Filikapec/deltaf/README.md

# DELTAF
Source code for project DELTA F

Glavni program se nalazi u dokumentu "app finalno.py"

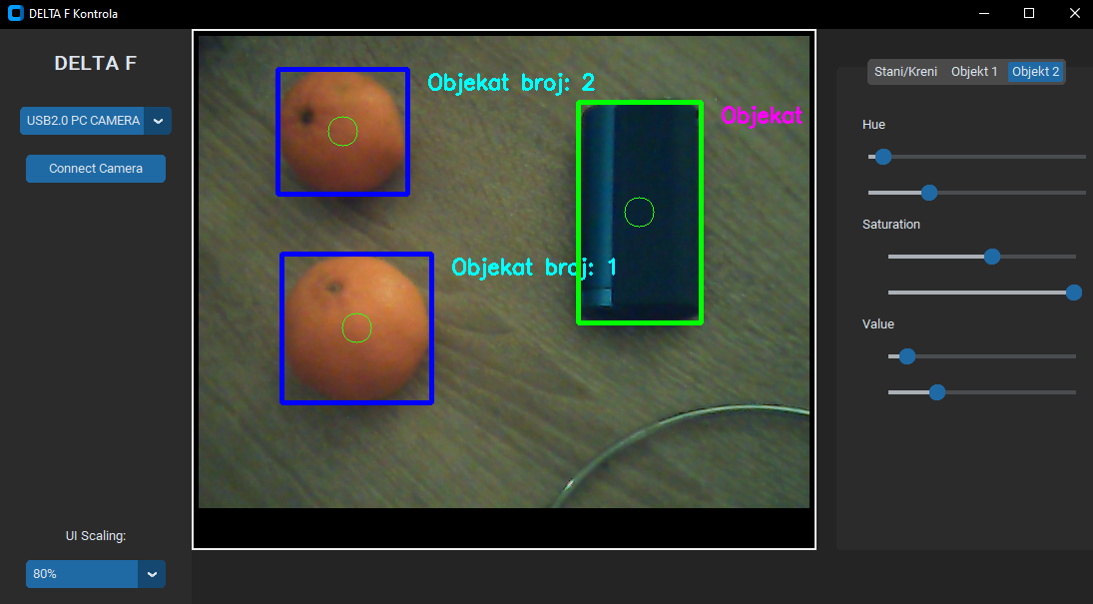
[picture p1: slika_programa_17122022_0218.PNG]


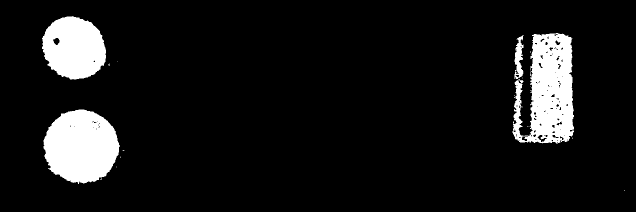
[picture p2: slika_programa_17122022_0218_2.PNG]


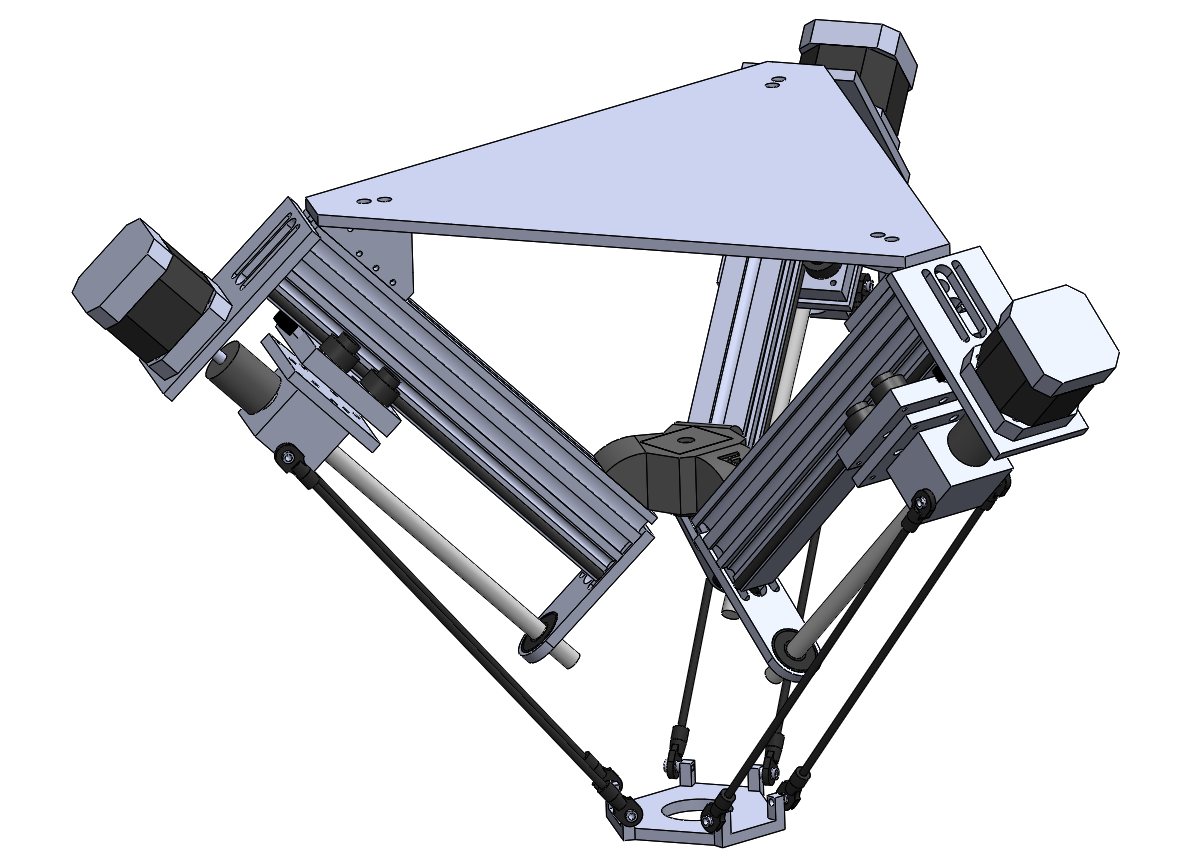
[picture p3: cela delta.PNG]
