Filikapec/deltaf/CELA DELTA.STEP

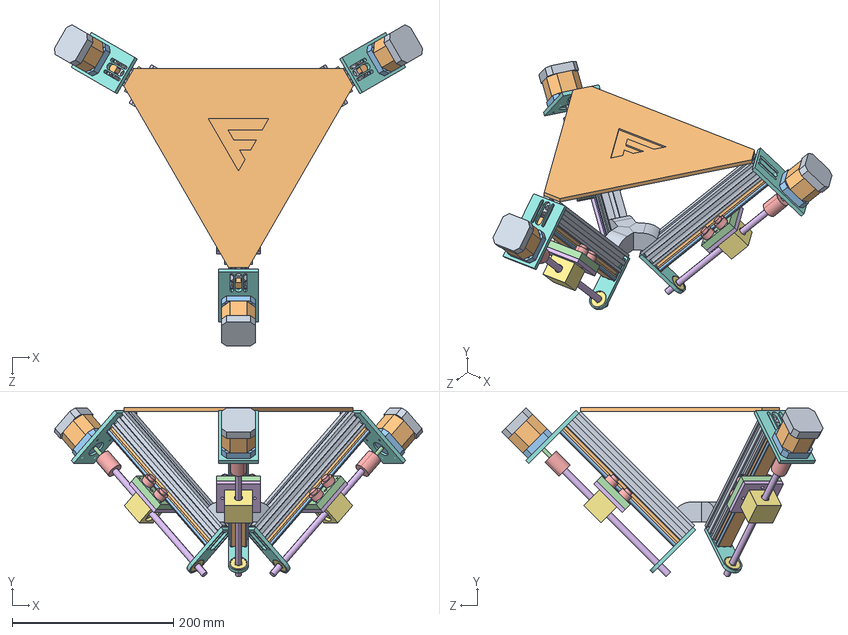
[picture p16: CAD file, 2023-03-24]
CELA DELTA.STEP
456.6 x 210.1 x 398.6 mm
Profil 25x25 x 3
sina x 3
sinavaljak x 6
klizacposini x 3
lagernakolicima x 12
klizacspojsakucistem x 3
kucistematica x 3
nosac motora x 3
stepperdonjideo x 3
steppersrednjideo x 3
steppergornjideo x 3
osovinasteppera x 3
spojnicamotorvreteno x 3
navojnovretenojednostavno x 3
lezaj neki x 3
nosac sa lezajem manji x 3
donja spojnica profila
Baza trouglasta sa logoom
