Filikapec/deltaf/app finalno.py

import tkinter as tk # pip install tk
import customtkinter # pip install customtkinter
import PIL.Image, PIL.ImageTk # pip install pillow
import cv2 # pip install opencv-python
from pygrabber.dshow_graph import FilterGraph # pip install pygrabber
import numpy as np
import sastavljanjeslika as slike
import klasapozicije as klasa
import serial
import time

customtkinter.set_appearance_mode("dark")  # Modes: "System" (standard), "Dark", "Light"
customtkinter.set_default_color_theme("blue")  # Themes: "blue" (standard), "green", "dark-blue"

pozicije = []
#brojobjekata = 0

#======================= SERIJSKA ============================
delta = serial.Serial(port='COM7', baudrate=9600, timeout=.1)
time.sleep(0.1)


class App(customtkinter.CTk):
    def __init__(self):
        super().__init__()

        # configure window
        self.title("DELTA F Kontrola")
        self.geometry("1100x580")

        # configure grid layout (4x4)
        self.grid_columnconfigure(1, weight=1)
        self.grid_columnconfigure((2, 3), weight=0)
        self.grid_rowconfigure((0, 1, 2), weight=1)

        # create sidebar frame with widgets
        self.sidebar_frame = customtkinter.CTkFrame(self, width=350, corner_radius=0)
        self.sidebar_frame.grid(row=0, column=0, rowspan=4, sticky="nsew")
        self.sidebar_frame.grid_rowconfigure(4, weight=1)
        self.logo_label = customtkinter.CTkLabel(self.sidebar_frame, text="DELTA F", font=customtkinter.CTkFont(size=20, weight="bold"))
        self.logo_label.grid(row=0, column=0, padx=20, pady=(20, 10))

        #get the available video devices
        self.graph = FilterGraph()
 
        # fill combobox with availible video devices
        self.combobox = customtkinter.CTkOptionMenu(self.sidebar_frame, values=self.graph.get_input_devices())
        self.combobox.grid(row=1, column=0, padx=20, pady=(20, 10))

        # connect button
        self.sidebar_button_1 = customtkinter.CTkButton(self.sidebar_frame, text="Connect Camera", command=self.sidebar_button_event)
        self.sidebar_button_1.grid(row=2, column=0, padx=20, pady=10)

        self.tabview = customtkinter.CTkTabview(self, width=250)
        self.tabview.grid(row=0, column=2, padx=(20, 0), pady=(20, 0), sticky="nsew")
        self.tabview.add("Stani/Kreni")
        self.tabview.add("Objekt 1")
        self.tabview.add("Objekt 2")
        self.tabview.tab("Stani/Kreni").grid_columnconfigure(0, weight=1)  # configure grid of individual tabs
        self.tabview.tab("Objekt 1").grid_columnconfigure(0, weight=1)
        #prvi tab
        self.zapocnibtn = customtkinter.CTkButton(self.tabview.tab("Stani/Kreni"), text="Zapocni", command=self.pozicijeIspis)
        self.zaustavibtn = customtkinter.CTkButton(self.tabview.tab("Stani/Kreni"), text="Zaustavi")
        self.sakrijplatformubtn = customtkinter.CTkButton(self.tabview.tab("Stani/Kreni"), text="Pregledaj", command=self.sakrijplatformu)
        self.zapocnibtn.grid(row=0, column=0, padx=20, pady=(30,10))
        self.zaustavibtn.grid(row=1, column=0, padx=20, pady=10)
        self.sakrijplatformubtn.grid(row=2, column=0, padx=20, pady=10)
        #drugi tab
        self.slider_progressbar_frame = customtkinter.CTkFrame(self.tabview.tab("Objekt 1"), fg_color="transparent")
        self.slider_progressbar_frame.grid(row=1, column=1, columnspan=2, padx=(20, 0), pady=(20, 0), sticky="nsew")
        self.slider_progressbar_frame.grid_columnconfigure(0, weight=1)
        self.slider_progressbar_frame.grid_rowconfigure(4, weight=1)
        #treci tab
        self.slider_progressbar_frame2 = customtkinter.CTkFrame(self.tabview.tab("Objekt 2"), fg_color="transparent")
        self.slider_progressbar_frame2.grid(row=1, column=1, columnspan=2, padx=(20, 0), pady=(20, 0), sticky="nsew")
        self.slider_progressbar_frame2.grid_columnconfigure(0, weight=1)
        self.slider_progressbar_frame2.grid_rowconfigure(4, weight=1)
        #HSV1
        self.labelH1 = customtkinter.CTkLabel(self.slider_progressbar_frame, text="Hue")
        self.labelH1.grid(row=0, column=0, padx=(0,0), pady=(0, 0), sticky="nw")
        self.slider_1 = customtkinter.CTkSlider(self.slider_progressbar_frame, from_=0, to=180, number_of_steps=180)
        self.slider_1.grid(row=1, column=0, padx=(0, 0), pady=(10, 10), sticky="ew")
        self.labelS1 = customtkinter.CTkLabel(self.slider_progressbar_frame, text="Saturation")
        self.labelS1.grid(row=3, column=0, padx=(0,0), pady=(0, 0), sticky="nw")
        self.slider_2 = customtkinter.CTkSlider(self.slider_progressbar_frame, from_=0, to=255, number_of_steps=180)
        self.slider_2.grid(row=4, column=0, padx=(20, 10), pady=(10, 10), sticky="ew")
        self.labelV1 = customtkinter.CTkLabel(self.slider_progressbar_frame, text="Value")
        self.labelV1.grid(row=6, column=0, padx=(0,0), pady=(0, 0), sticky="nw")
        self.slider_3 = customtkinter.CTkSlider(self.slider_progressbar_frame, from_=0, to=255, number_of_steps=180)
        self.slider_3.grid(row=7, column=0, padx=(20, 10), pady=(10, 10), sticky="ew")
        #HSV2
        self.slider_4 = customtkinter.CTkSlider(self.slider_progressbar_frame, from_=0, to=180, number_of_steps=180)
        self.slider_4.grid(row=2, column=0, padx=(0, 0), pady=(10, 10), sticky="ew")
        self.slider_5 = customtkinter.CTkSlider(self.slider_progressbar_frame, from_=0, to=255, number_of_steps=180)
        self.slider_5.grid(row=5, column=0, padx=(20, 10), pady=(10, 10), sticky="ew")
        self.slider_6 = customtkinter.CTkSlider(self.slider_progressbar_frame, from_=0, to=255, number_of_steps=180)
        self.slider_6.grid(row=8, column=0, padx=(20, 10), pady=(10, 10), sticky="ew")
        #HSV3
        self.labelH12 = customtkinter.CTkLabel(self.slider_progressbar_frame2, text="Hue")
        self.labelH12.grid(row=0, column=0, padx=(0,0), pady=(0, 0), sticky="nw")
        self.slider_12 = customtkinter.CTkSlider(self.slider_progressbar_frame2, from_=0, to=180, number_of_steps=180)
        self.slider_12.grid(row=1, column=0, padx=(0, 0), pady=(10, 10), sticky="ew")
        self.labelS12 = customtkinter.CTkLabel(self.slider_progressbar_frame2, text="Saturation")
        self.labelS12.grid(row=3, column=0, padx=(0,0), pady=(0, 0), sticky="nw")
        self.slider_22 = customtkinter.CTkSlider(self.slider_progressbar_frame2, from_=0, to=255, number_of_steps=180)
        self.slider_22.grid(row=4, column=0, padx=(20, 10), pady=(10, 10), sticky="ew")
        self.labelV12 = customtkinter.CTkLabel(self.slider_progressbar_frame2, text="Value")
        self.labelV12.grid(row=6, column=0, padx=(0,0), pady=(0, 0), sticky="nw")
        self.slider_32 = customtkinter.CTkSlider(self.slider_progressbar_frame2, from_=0, to=255, number_of_steps=180)
        self.slider_32.grid(row=7, column=0, padx=(20, 10), pady=(10, 10), sticky="ew")
        #HSV4
        self.slider_42 = customtkinter.CTkSlider(self.slider_progressbar_frame2, from_=0, to=180, number_of_steps=180)
        self.slider_42.grid(row=2, column=0, padx=(0, 0), pady=(10, 10), sticky="ew")
        self.slider_52 = customtkinter.CTkSlider(self.slider_progressbar_frame2, from_=0, to=255, number_of_steps=180)
        self.slider_52.grid(row=5, column=0, padx=(20, 10), pady=(10, 10), sticky="ew")
        self.slider_62 = customtkinter.CTkSlider(self.slider_progressbar_frame2, from_=0, to=255, number_of_steps=180)
        self.slider_62.grid(row=8, column=0, padx=(20, 10), pady=(10, 10), sticky="ew")

        self.scaling_label = customtkinter.CTkLabel(self.sidebar_frame, text="UI Scaling:", anchor="w")
        self.scaling_label.grid(row=7, column=0, padx=20, pady=(10, 0))
        self.scaling_optionemenu = customtkinter.CTkOptionMenu(self.sidebar_frame, values=["80%", "90%", "100%", "110%", "120%"], command=self.change_scaling_event)
        self.scaling_optionemenu.grid(row=8, column=0, padx=20, pady=(10, 20))

        self.brojobjekata = 0

    def klizac(self, stagod):
        value = self.slider_1.get()
        print(self.slider_1.get())

    
    def change_scaling_event(self, new_scaling: str):
        new_scaling_float = int(new_scaling.replace("%", "")) / 100
        customtkinter.set_widget_scaling(new_scaling_float)
    
    def stabilisipozicije(self):
        #print(self.brojobjekata)
        elementi = []
        for i in range(self.brojobjekata):
            elementi.append(pozicije[len(pozicije)-self.brojobjekata+i])
        #pozicije = elementi

        return elementi
            
        
    def pozicijeIspis(self):
        #pozicije=[] #resetujem listu pozicija
        pozicije = self.stabilisipozicije()
        #print(brojobjekata)

        brojPredmeta = "R" + str(len(pozicije))
        delta.write(bytes(brojPredmeta, 'utf-8'))
        print(bytes(brojPredmeta, 'utf-8'))

        time.sleep(0.5)

        
        for i in range(len(pozicije)):
            #print(str(pozicije[i].x) + " " + str(pozicije[i].y) + " " + str(pozicije[i].gr))
            pozicije[i].x = (pozicije[i].x - 248) * 23.7 / 74
            pozicije[i].y = (pozicije[i].y - 248) * 23.7 / 74
            #print(str(pozicije[i].x) + " " + str(pozicije[i].y) + " " + str(pozicije[i].gr))
            pozicijaZaPoslati = str(str(round(pozicije[i].y, 2)) + " " + str(round(pozicije[i].x, 2)) + " " + "23") #23=4+19
            #delta.write(bytes(pozicijaZaPoslati, 'utf-8'))
            #print("---------------------------------")
            print(bytes(pozicijaZaPoslati, 'utf-8'))
            delta.write(bytes(pozicijaZaPoslati, 'utf-8'))
            time.sleep(1)


    def sakrijplatformu(self):
        speckar = "K"
        delta.write(bytes(speckar, 'utf-8'))
        time.sleep(0.5)


    def sidebar_button_event(self):
        
        print("try to open camera: " + self.combobox.get())   

        for i, device in enumerate(self.graph.get_input_devices() ):   
            if device == self.combobox.get():
                self.video_source = i

        # main window
        self.vid = MyVideoCapture(self.video_source)

        # Create a canvas that can fit the above video source size
        self.canvas = tk.Canvas(self, width=self.vid.width, height = self.vid.height, background="#000000", borderwidth=cv2.BORDER_TRANSPARENT, border=cv2.BORDER_TRANSPARENT)  #width = self.vid.width
        self.canvas.grid(row=0, column=1, padx=(0, 0), pady=(0, 0), sticky="nsew")

        self.delay = 15
        self.update()        


    
    # Get a frame from the video source
    def update(self):
        return_value, frame = self.vid.get_frame()
        #print(self.brojobjekata)

        if return_value:
            try:
                #analyze Frame and check for QR Code
                frame = slike.stackImages(1, ([self.analyzeFrame(frame)]))
                
                self.photo = PIL.ImageTk.PhotoImage(image = PIL.Image.fromarray(frame))
                self.canvas.create_image(0, 0, image = self.photo, anchor = tk.NW)

            except BaseException:
                    '''import sys
                    print(sys.exc_info()[0])
                    import traceback
                    print(traceback.format_exc())  '''
            finally:
                pass
        
        self.after(self.delay, self.update)

    #search for QR Code in frame
    def analyzeFrame(self, frame):
        font = cv2.FONT_HERSHEY_SIMPLEX
        img = cv2.cvtColor(frame, cv2.COLOR_BGR2HSV)
        #lower = np.array([0, 0, 0])
        lower = np.array([self.slider_1.get(), self.slider_2.get(), self.slider_3.get()])
        #upper = np.array([180, 115, 102])
        upper = np.array([self.slider_4.get(), self.slider_5.get(), self.slider_6.get()])
        #lower = np.array([0, 0, 0])
        lower2 = np.array([self.slider_12.get(), self.slider_22.get(), self.slider_32.get()])
        #upper = np.array([180, 115, 102])
        upper2 = np.array([self.slider_42.get(), self.slider_52.get(), self.slider_62.get()])
        mask = cv2.inRange(img, lower, upper)
        mask2 = cv2.inRange(img, lower2, upper2)

        mask_contours, hierarchy = cv2.findContours(mask, cv2.RETR_EXTERNAL, cv2.CHAIN_APPROX_SIMPLE)
        mask_contours2, hierarchy2 = cv2.findContours(mask2, cv2.RETR_EXTERNAL, cv2.CHAIN_APPROX_SIMPLE)

        brojregistrovanihobjekata = 0
        if len(mask_contours) != 0:
            indexobjekta =0
            for mask_contour in mask_contours:
                if cv2.contourArea(mask_contour) > 500:
                    x, y, w, h = cv2.boundingRect(mask_contour)
                    pozicije.append(klasa.Pozicija(x+w/2, y+h/2, indexobjekta))  #ovo iskoristiti
                    cv2.rectangle(frame, (x, y), (x + w, y + h), (0, 0, 255), 3) #drawing rectangle
                    cv2.circle(frame, (int(x+w/2), int(y+h/2)), 15, (50,255, 20))
                    indexobjekta+=1
                    brojregistrovanihobjekata+=1
                    cv2.putText(frame, ("Objekat broj: " + str(indexobjekta)), (x+w+20, y+20), cv2.FONT_HERSHEY_SIMPLEX, 0.7, (0,255,255), 2)
                    #cv2.putText(frame, ("Dimenzije: " + str(w) + " " + str(h)), (x,y), cv2.FONT_HERSHEY_SIMPLEX, 0.7, (0,255,255), 2)
                    #cv2.putText(frame, ("Poz: " + str(x+w/2) + " " + str(y+h/2)), (x,y), cv2.FONT_HERSHEY_SIMPLEX, 0.7, (0,255,255), 2)
                    cv2.putText(frame, ("Poz: " + str(round((((y+h/2)-248) * 23.7 / 74), 2)) + " " + str(round((((x+w/2) - 248) * 23.7 / 74), 2))), (x,y), cv2.FONT_HERSHEY_SIMPLEX, 0.7, (0,255,255), 2)

        if len(mask_contours2) != 0:
            indexobjekta =0
            for mask_contour2 in mask_contours2:
                if cv2.contourArea(mask_contour2) > 500:
                    x, y, w, h = cv2.boundingRect(mask_contour2)
                    pozicije.append(klasa.Pozicija(x+w/2, y+h/2, indexobjekta))
                    cv2.rectangle(frame, (x, y), (x + w, y + h), (0, 255, 0), 3) #drawing rectangle
                    cv2.circle(frame, (int(x+w/2), int(y+h/2)), 15, (50,255, 20))
                    indexobjekta+=1
                    brojregistrovanihobjekata+=1
                    cv2.putText(frame, ("Objekat broj: " + str(indexobjekta)), (x+w+20, y+20), cv2.FONT_HERSHEY_SIMPLEX, 0.7, (255,0,255), 2)
        
        self.brojobjekata = brojregistrovanihobjekata
        

        cv2.imshow("Izgled", slike.stackImages(0.5, ([mask, mask2],[mask, mask2])))
        return [frame, mask]

class MyVideoCapture:
    def __init__(self, video_source=0):
        # Open the video source
        self.vid = cv2.VideoCapture(video_source)
        if not self.vid.isOpened():
            raise ValueError("Unable to open video source", video_source)

        # Get video source width and height
        self.width = self.vid.get(cv2.CAP_PROP_FRAME_WIDTH)
        self.height = self.vid.get(cv2.CAP_PROP_FRAME_HEIGHT)

    def get_frame(self):
        if not self.vid.isOpened():
            return (return_value, None)

        return_value, frame = self.vid.read()
        if return_value:
            # Return a boolean success flag and the current frame converted to BGR
            return (return_value, cv2.cvtColor(frame, cv2.COLOR_BGR2RGB))
        else:
            return (return_value, None)

    # Release the video source when the object is destroyed
    def __del__(self):
        if self.vid.isOpened():
            self.vid.release()


if __name__ == "__main__":
    app = App()
    app.mainloop()


#Proporcija je da je 150px = 50mm
# Preciznije 74px = 23.7mm

#32.4 i 35
