Filikapec/deltaf/ekran.py

self.title("Kontrola")
        self.geometry(f"{1100}x{580}")

        self.grid_columnconfigure(1, weight=1)
        self.grid_columnconfigure((2, 3), weight=0)
        self.grid_rowconfigure((0, 1, 2), weight=1)
        self.sidebar_frame = customtkinter.CTkFrame(self, width=140, corner_radius=0)
        self.sidebar_frame.grid(row=0, column=0, rowspan=4, sticky="nsew")
        self.sidebar_frame.grid_rowconfigure(4, weight=1)
        self.logo_label = customtkinter.CTkLabel(self.sidebar_frame, text="DeltaControl", font=customtkinter.CTkFont(size=20, weight="bold"))
        self.logo_label.grid(row=0, column=0, padx=20, pady=(20, 10))
        self.sidebar_button_1 = customtkinter.CTkButton(self.sidebar_frame, command=self.onama, text="O nama")
        self.sidebar_button_1.grid(row=1, column=0, padx=20, pady=10)
        self.appearance_mode_label = customtkinter.CTkLabel(self.sidebar_frame, text="Tema izgleda:", anchor="w")
        self.appearance_mode_label.grid(row=5, column=0, padx=20, pady=(10, 0))
        self.appearance_mode_optionemenu = customtkinter.CTkOptionMenu(self.sidebar_frame, values=["Dark", "Light", "System"], command=self.change_appearance_mode_event)
        self.appearance_mode_optionemenu.grid(row=6, column=0, padx=20, pady=(10, 10))
        self.scaling_label = customtkinter.CTkLabel(self.sidebar_frame, text="UI Scaling:", anchor="w")
        self.scaling_label.grid(row=7, column=0, padx=20, pady=(10, 0))
        self.scaling_optionemenu = customtkinter.CTkOptionMenu(self.sidebar_frame, values=["80%", "90%", "100%", "110%", "120%"], command=self.change_scaling_event)
        self.scaling_optionemenu.grid(row=8, column=0, padx=20, pady=(10, 20))

        #Komandna linija i dugme
        self.entry = customtkinter.CTkEntry(self, placeholder_text="CTkEntry")
        self.entry.grid(row=3, column=1, columnspan=2, padx=(20, 0), pady=(20, 20), sticky="nsew")
        self.main_button_1 = customtkinter.CTkButton(master=self, fg_color="transparent", border_width=2, text_color=("gray10", "#DCE4EE"), text="OK")
        self.main_button_1.grid(row=3, column=3, padx=(20, 20), pady=(20, 20), sticky="nsew")

        #Podesavanje boja
        '''self.slider_progressbar_frame = customtkinter.CTkFrame(self, fg_color="transparent")
        self.slider_progressbar_frame.grid(row=1, column=1, columnspan=2, padx=(20, 0), pady=(20, 0), sticky="nsew")
        self.slider_progressbar_frame.grid_columnconfigure(0, weight=1)
        self.slider_progressbar_frame.grid_rowconfigure(4, weight=1)
        self.seg_button_1 = customtkinter.CTkSegmentedButton(self.slider_progressbar_frame)
        self.seg_button_1.grid(row=0, column=0, padx=(20, 10), pady=(10, 10), sticky="ew")
        self.progressbar_1 = customtkinter.CTkProgressBar(self.slider_progressbar_frame)
        self.progressbar_1.grid(row=1, column=0, padx=(20, 10), pady=(10, 10), sticky="ew")
        self.progressbar_2 = customtkinter.CTkProgressBar(self.slider_progressbar_frame)
        self.progressbar_2.grid(row=2, column=0, padx=(20, 10), pady=(10, 10), sticky="ew")
        self.slider_1 = customtkinter.CTkSlider(self.slider_progressbar_frame, from_=0, to=1, number_of_steps=4)
        self.slider_1.grid(row=3, column=0, padx=(20, 10), pady=(10, 10), sticky="ew")
        self.slider_2 = customtkinter.CTkSlider(self.slider_progressbar_frame, orientation="vertical")
        self.slider_2.grid(row=0, column=1, rowspan=5, padx=(10, 10), pady=(10, 10), sticky="ns")
        self.progressbar_3 = customtkinter.CTkProgressBar(self.slider_progressbar_frame, orientation="vertical")
        self.progressbar_3.grid(row=0, column=2, rowspan=5, padx=(10, 20), pady=(10, 10), sticky="ns")'''

        _, cv2img = kamera.read()
        cv2img = cv2.cvtColor(cv2img, cv2.COLOR_BGR2RGB)
        pil_img = Image.fromarray(cv2img)

        self.kameraprikaz = customtkinter.CTkImage(pil_img, size=(500,150))
        self.slika = customtkinter.CTkLabel(self, width=250, image=self.kameraprikaz)
        self.slika.grid(row=0, column=1, padx=(20, 0), pady=(20, 0), sticky="nsew")

        self.home_frame = customtkinter.CTkFrame(self, corner_radius=0, fg_color="transparent")
        self.home_frame.grid_columnconfigure(0, weight=1)
        self.home_frame_kameraprikaz_label = customtkinter.CTkLabel(self.home_frame, text="", image=self.kameraprikaz)
        self.home_frame_kameraprikaz_label.grid(row=0, column=0, padx=20, pady=10)

    def open_input_dialog_event(self):
        dialog = customtkinter.CTkInputDialog(text="Type in a number:", title="CTkInputDialog")
        print("CTkInputDialog:", dialog.get_input())

    def change_appearance_mode_event(self, new_appearance_mode: str):
        customtkinter.set_appearance_mode(new_appearance_mode)

    def change_scaling_event(self, new_scaling: str):
        new_scaling_float = int(new_scaling.replace("%", "")) / 100
        customtkinter.set_widget_scaling(new_scaling_float)

    def onama(self):
        print("Pokazi nesto o nama")
